DgDamis/Termokamera/README.md

# Thermal Camera
 Wemos D1 Mini and AMG 8833 based thermal imaging device, a PlatformIO project.

Device preview
<h3>Part list:</h3>
<ul>
	<li>Wemos D1 mini,</li>
	<li>infrared sensor AMG8833</li>
	<li>LCD ILI9341 240x320 px,</li>
	<li>Li-ion 18650 battery,</li>
	<li>Li-ion loader (battery charger) TP4056,</li>
	<li>DC-DC step up SX1308,</li>
	<li>2x 10 kΩ resistor,</li>
	<li>130 kΩ resistor,</li>
	<li>100 nF capacitor,</li>
	<li>switch and wires.</li>
</ul>

<h2>ročníkový projekt - termokamera</h2>
<p>Jedná se o přenosné zařízení zachycující termální stopu prostředí se zobrazením na displeji.</p>
<p>Vzhledem k tepelné citlivosti 8x8 bodů je vykreslení použitelného obrazu o vyšším rozlišení dosaženo interpolací dat.
Zařízení je napájeno bateriemi Li-ion 18650 s výstupním napětím +- 3,7 V.
Nabíjení je možné dvěma konektory  - Micro USB a USB-C - MAX 5 V!</p>

Presentation [Czech] - https://prezi.com/p/vnomt9wigawh/?present=1
