DgDamis/Termokamera/schema_termokamera.png

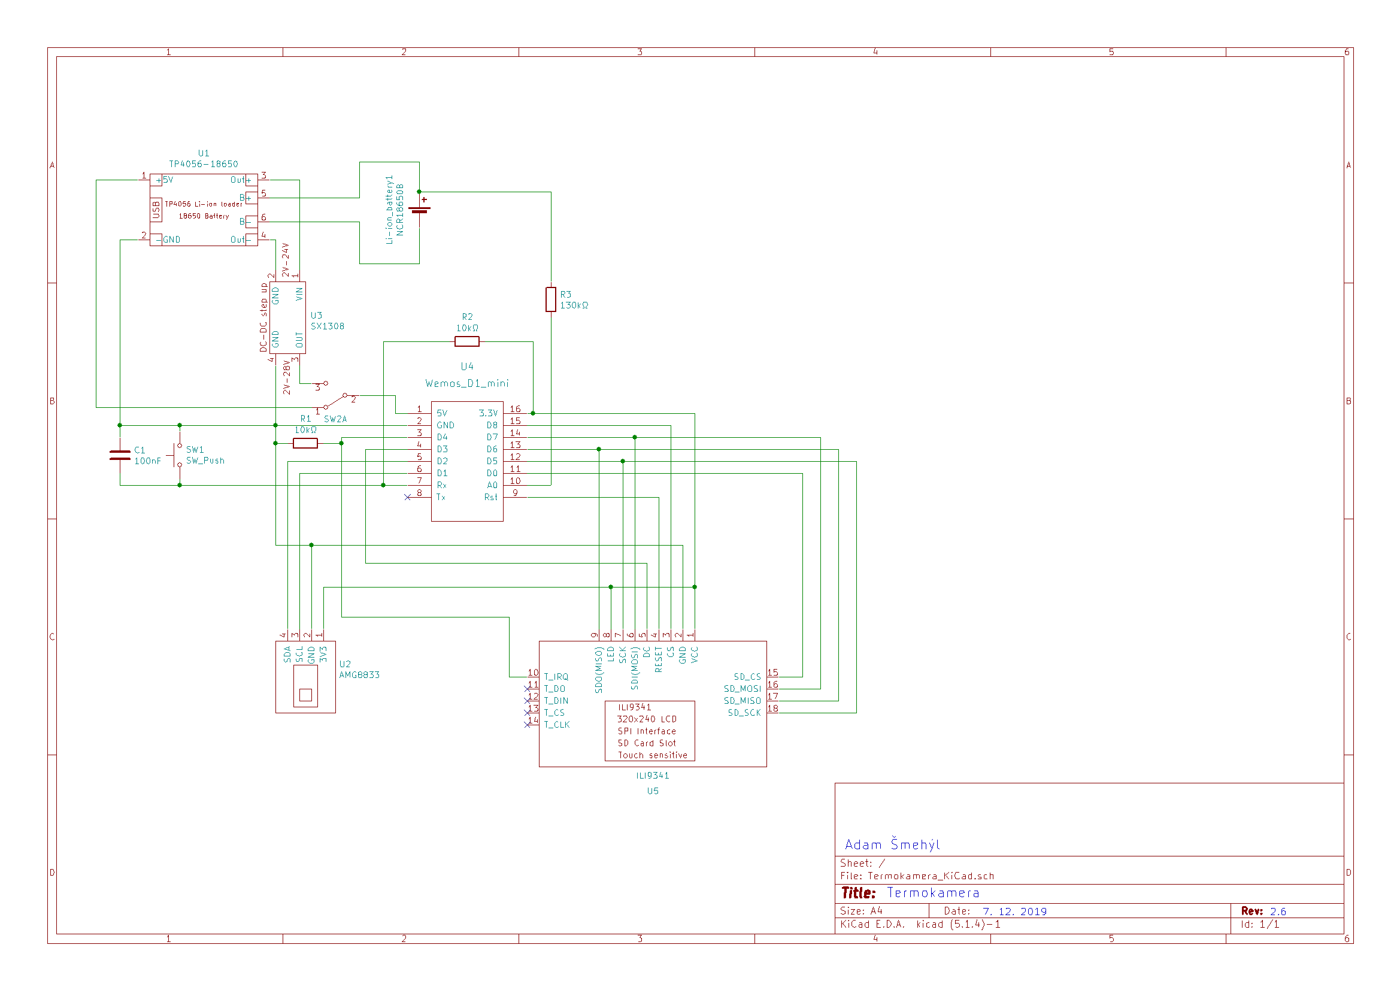
schema_termokamera.png
