DgDamis/Termokamera/(commit log)

2019-10-08 zaklady schema
    [Termokamera_KiCad.sch]
2019-10-09 Schema update
    [Termokamera_KiCad.sch]
2019-10-10 completed schematics
    [Termokamera_KiCad.sch]
2019-11-13 Update schematics to adaptate added SD connections
    [Termokamera_KiCad.sch]
2019-11-13 Figured out SD library problems, should be compilatable now
    [advanced.cpp]
2019-12-04 Fixed ambiguous class pointer
    [advanced.cpp]
2019-12-04 Reorganized pin usage
2019-12-04 Fixed interrupts, advanced version should work now
    [advanced.cpp]
2019-12-05 updated schema
    [Termokamera_KiCad.sch]
2019-12-07 Fixed Image Capture Button Sensing, Added directives for DEBUG (Serial com)
    [advanced.cpp]
2019-12-07 update schema, revision 2.6
    [Termokamera_KiCad.sch]
2019-12-10 Patches critical bug which has broken display, rollback to a stable battery measurement
    [advanced.cpp]
2020-01-08 Rotated Infrared capture to correct tilt
    Not really optimized, but it works
    [advanced.cpp]
